FranzImsch/DreamSteck/README.md

### 3x3 Macro Pad

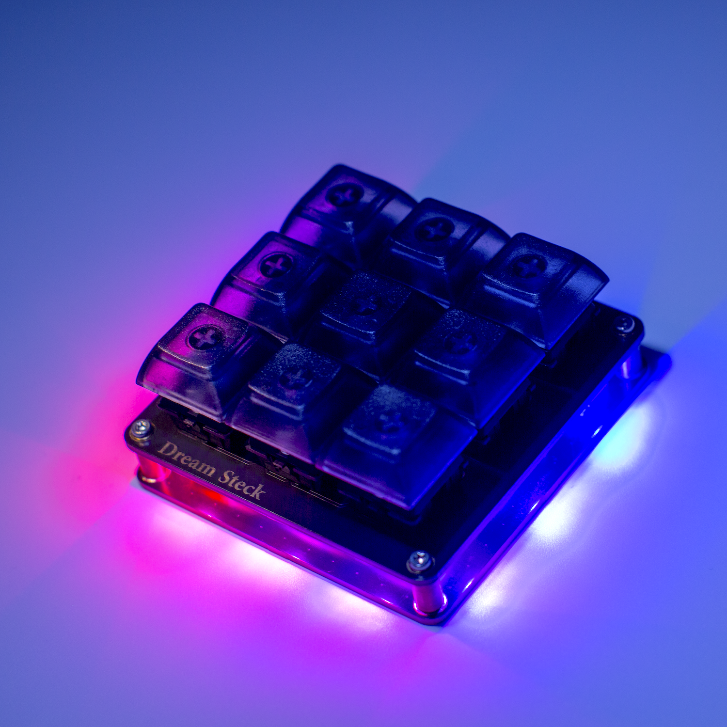
[picture p1: photo-1.png]
Overview photo


Based on nRF52840
