FranzImsch/DreamSteck/photo-2.png

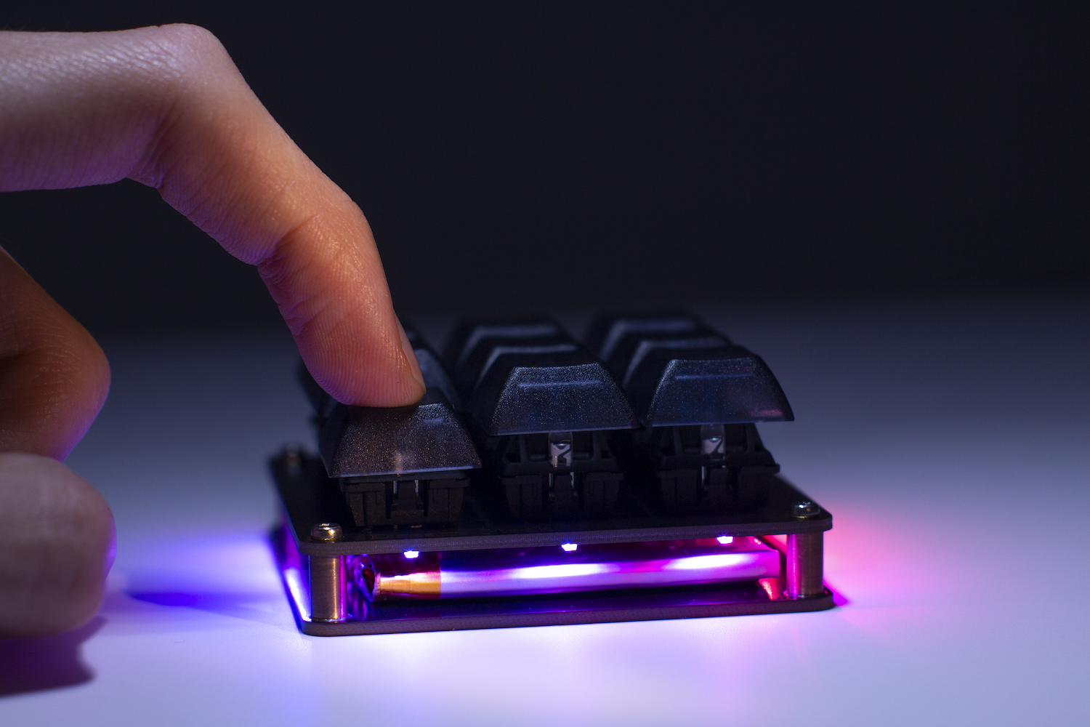
photo-2.png
