FranzImsch/DreamSteck/Schematic.pdf

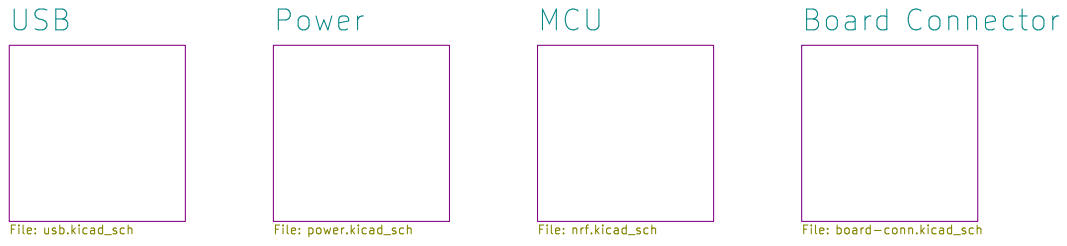
[picture p3: page 1]

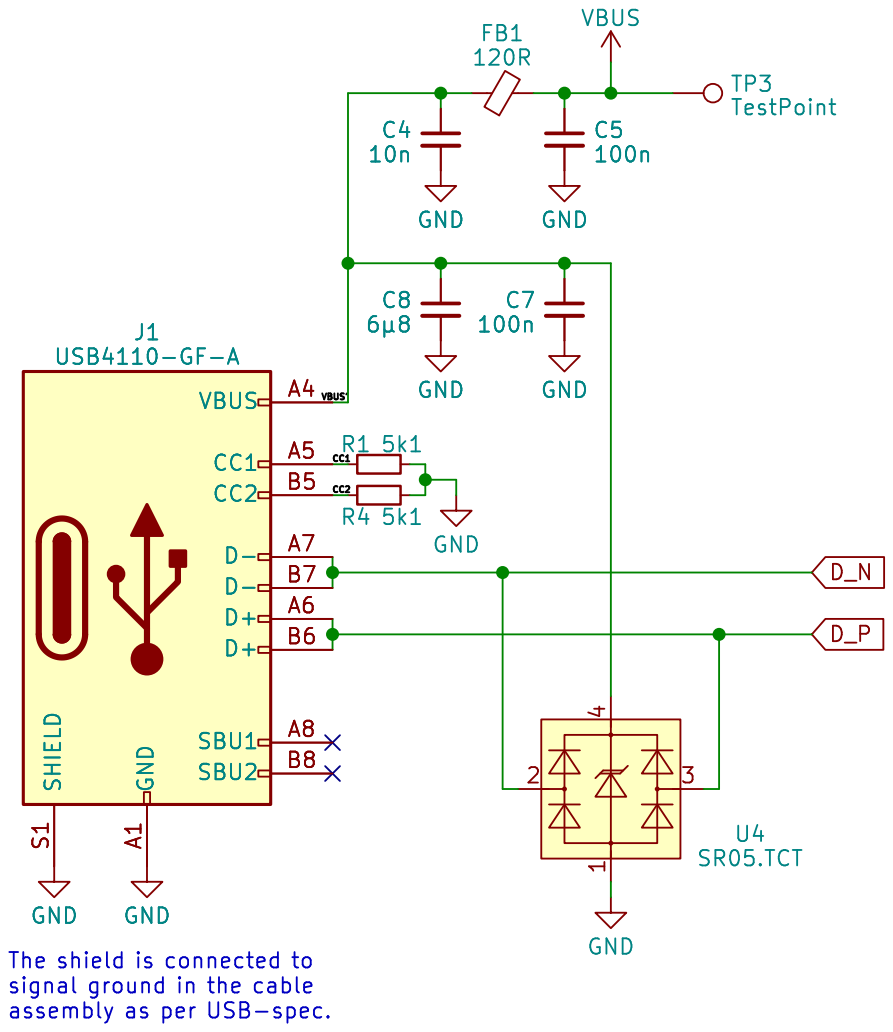
[picture p4: page 2]

signal ground in the cable

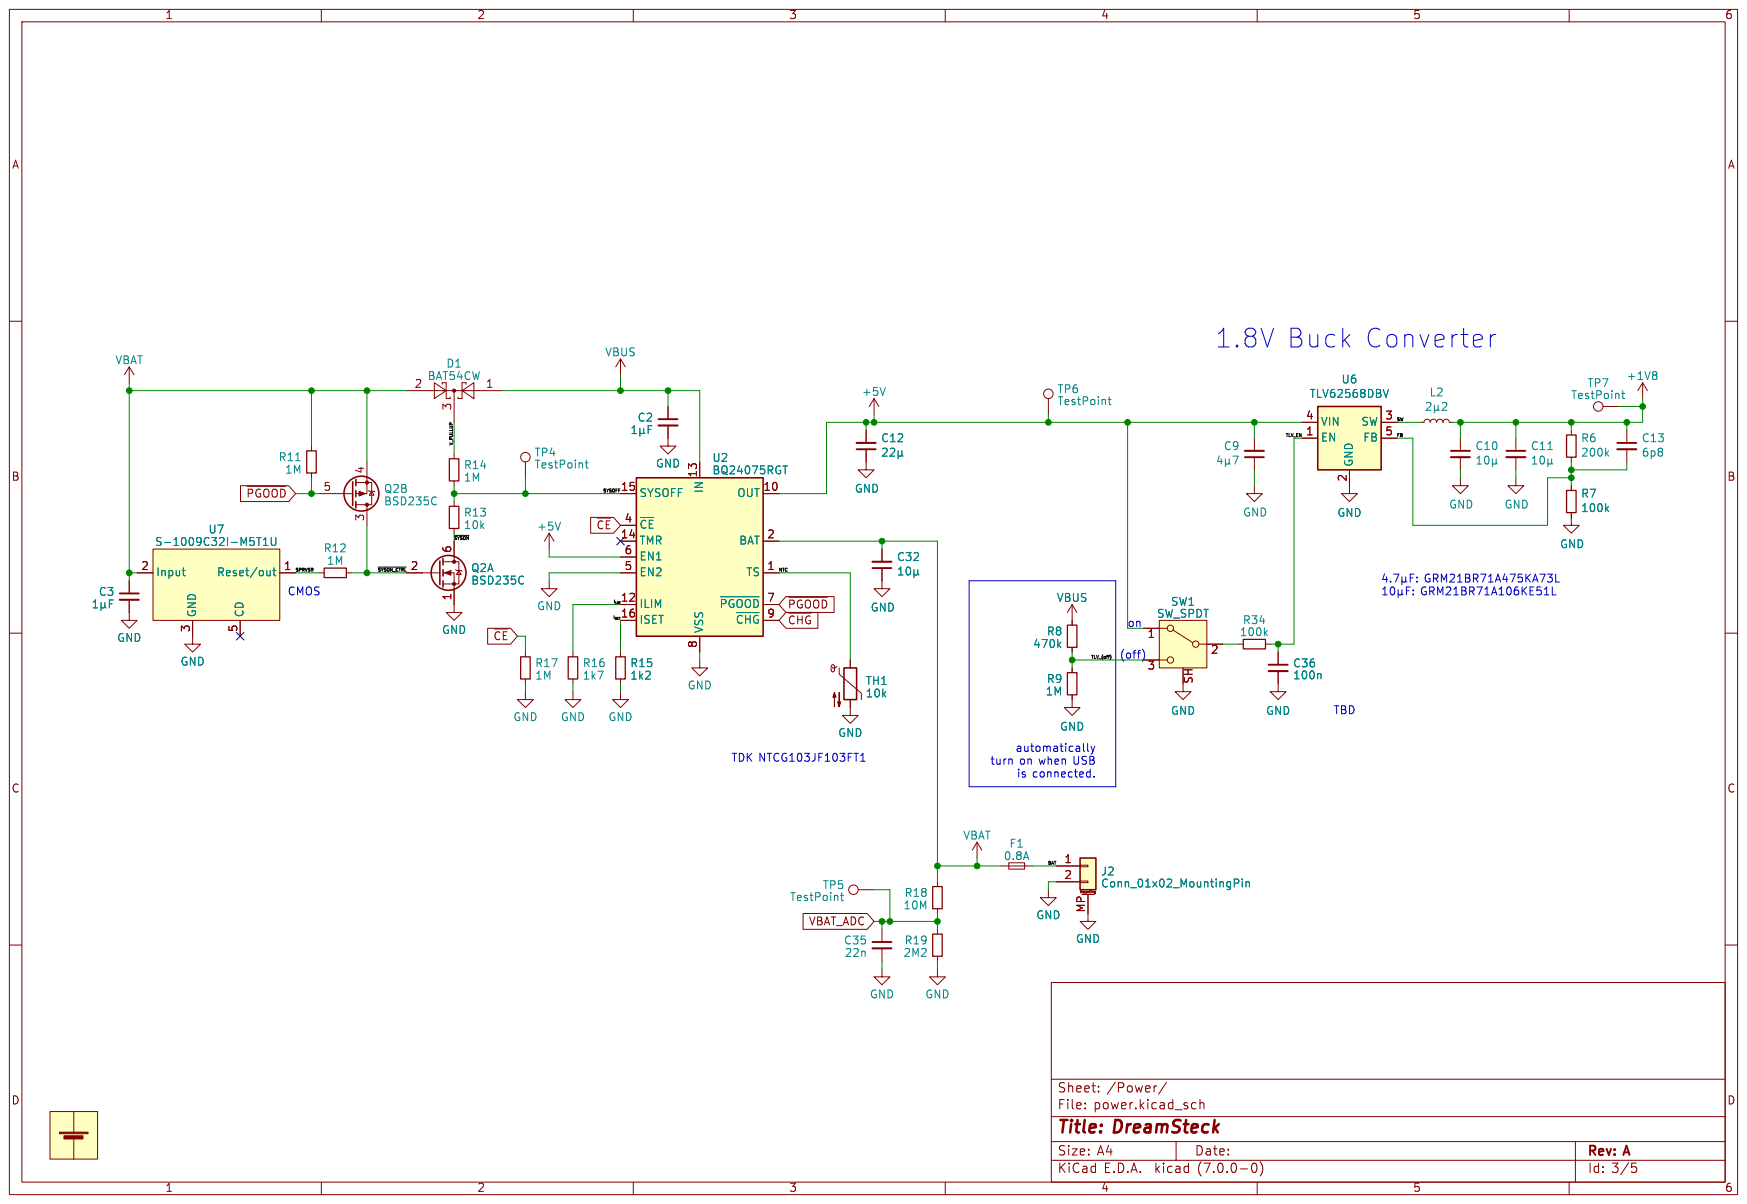
[picture p5: page 3]

automatically
turn on when USB
is connected.

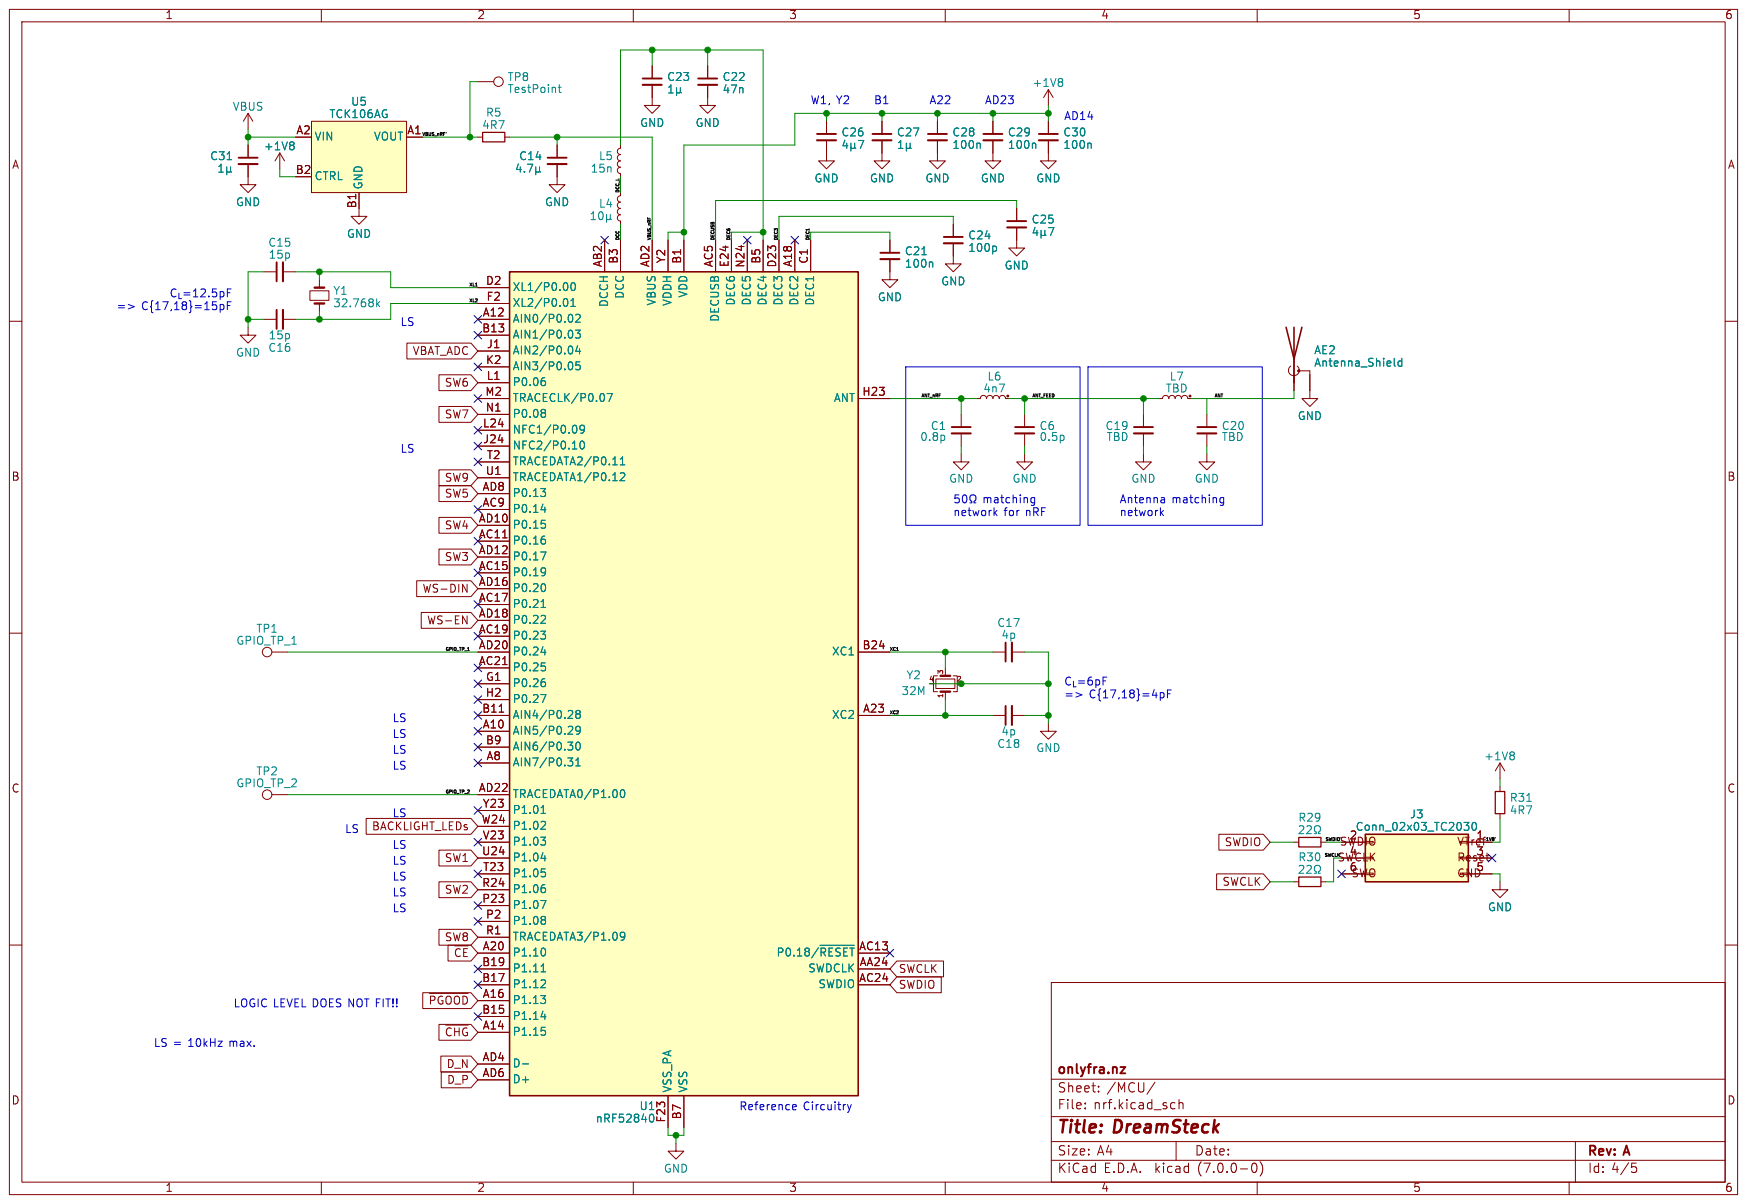
[picture p6: page 4]

LOGIC LEVEL DOES NOT FIT!!

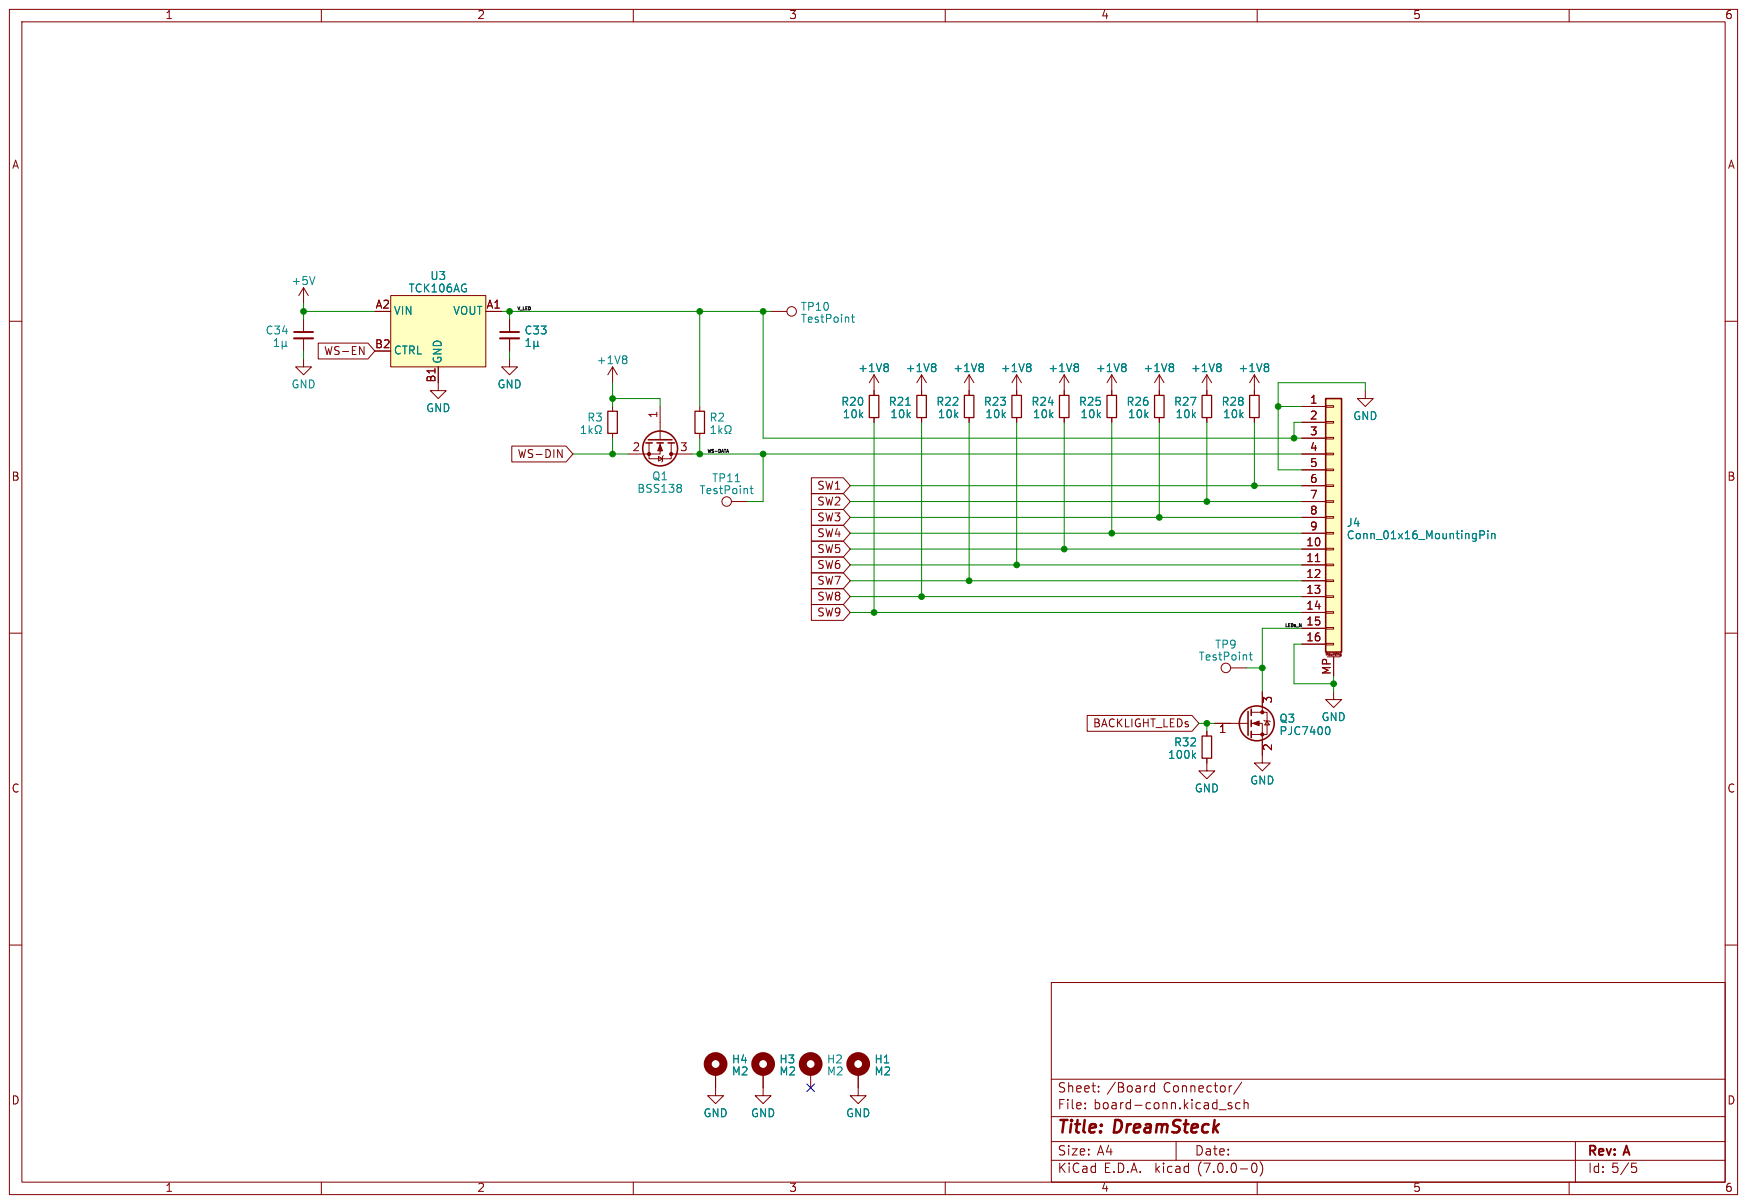
[picture p7: page 5]

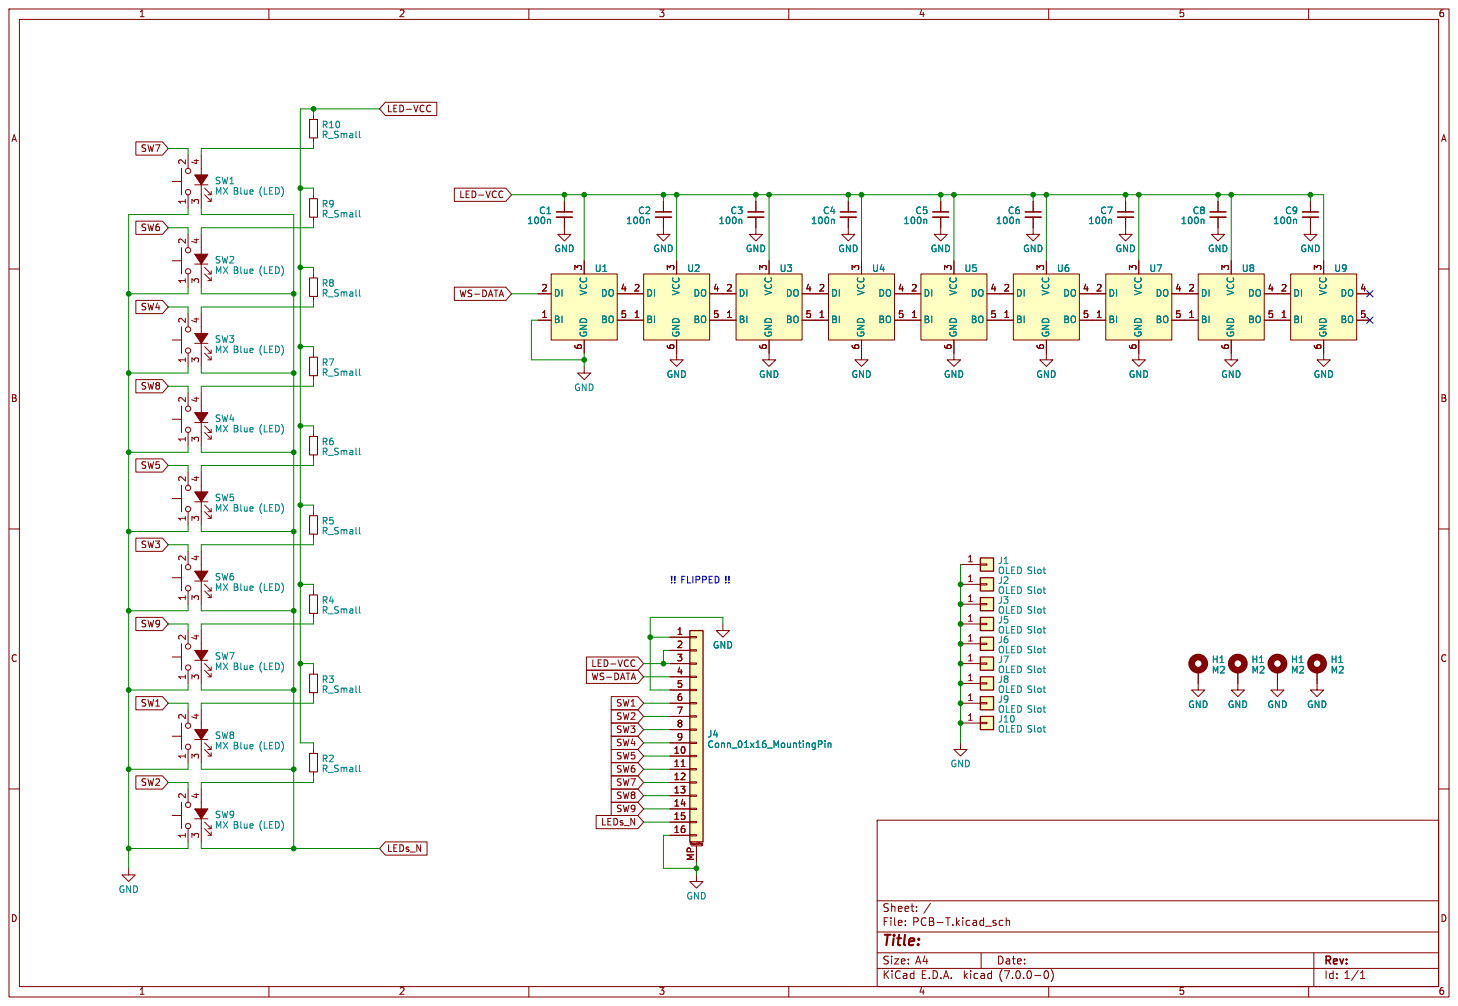
[picture p8: page 6]

3 4 SW5 MX Blue (LED) 1 J8OLED Slot 1 J1OLED Slot 1 J3OLED Slot 1 J2OLED Slot 1 J5OLED Slot 1 J6OLED Slot GND

3 4 SW9 MX Blue (LED) GND

3 4 SW6 MX Blue (LED) R4 R_Small GND
