FranzImsch/DreamSteck/KiCad/PCB-T/PCB-T.kicad_pcb

## KiCad design KiCad/PCB-T/PCB-T.kicad_pcb (2023-03-04)

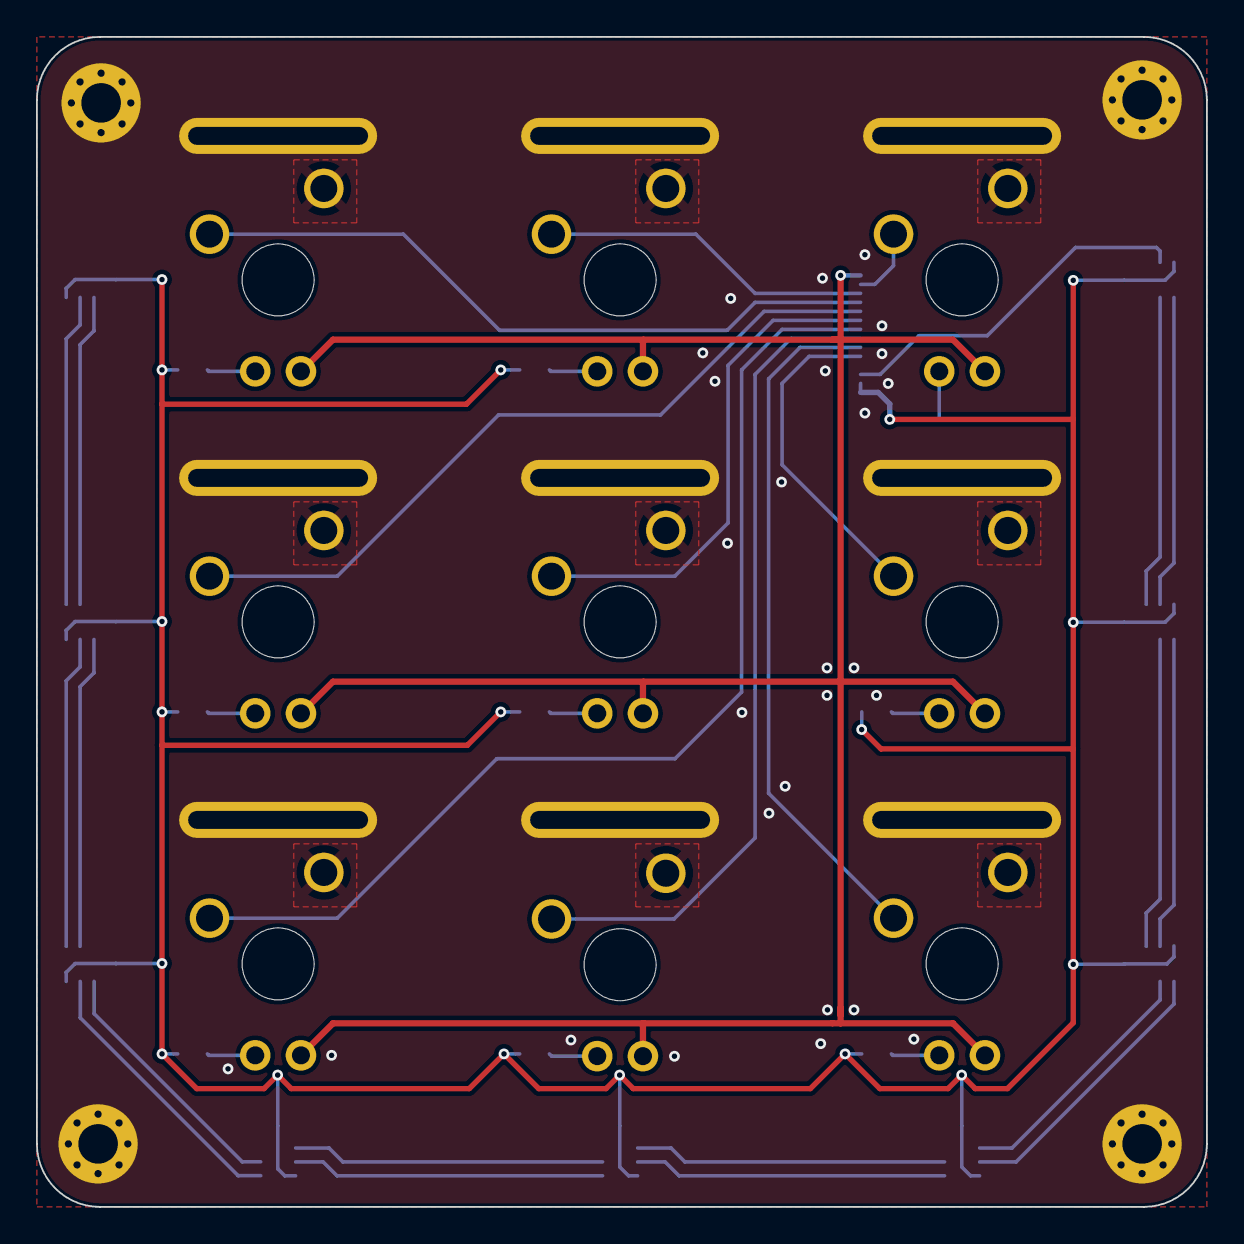
[picture p9: board PCB-T.kicad_pcb from above]

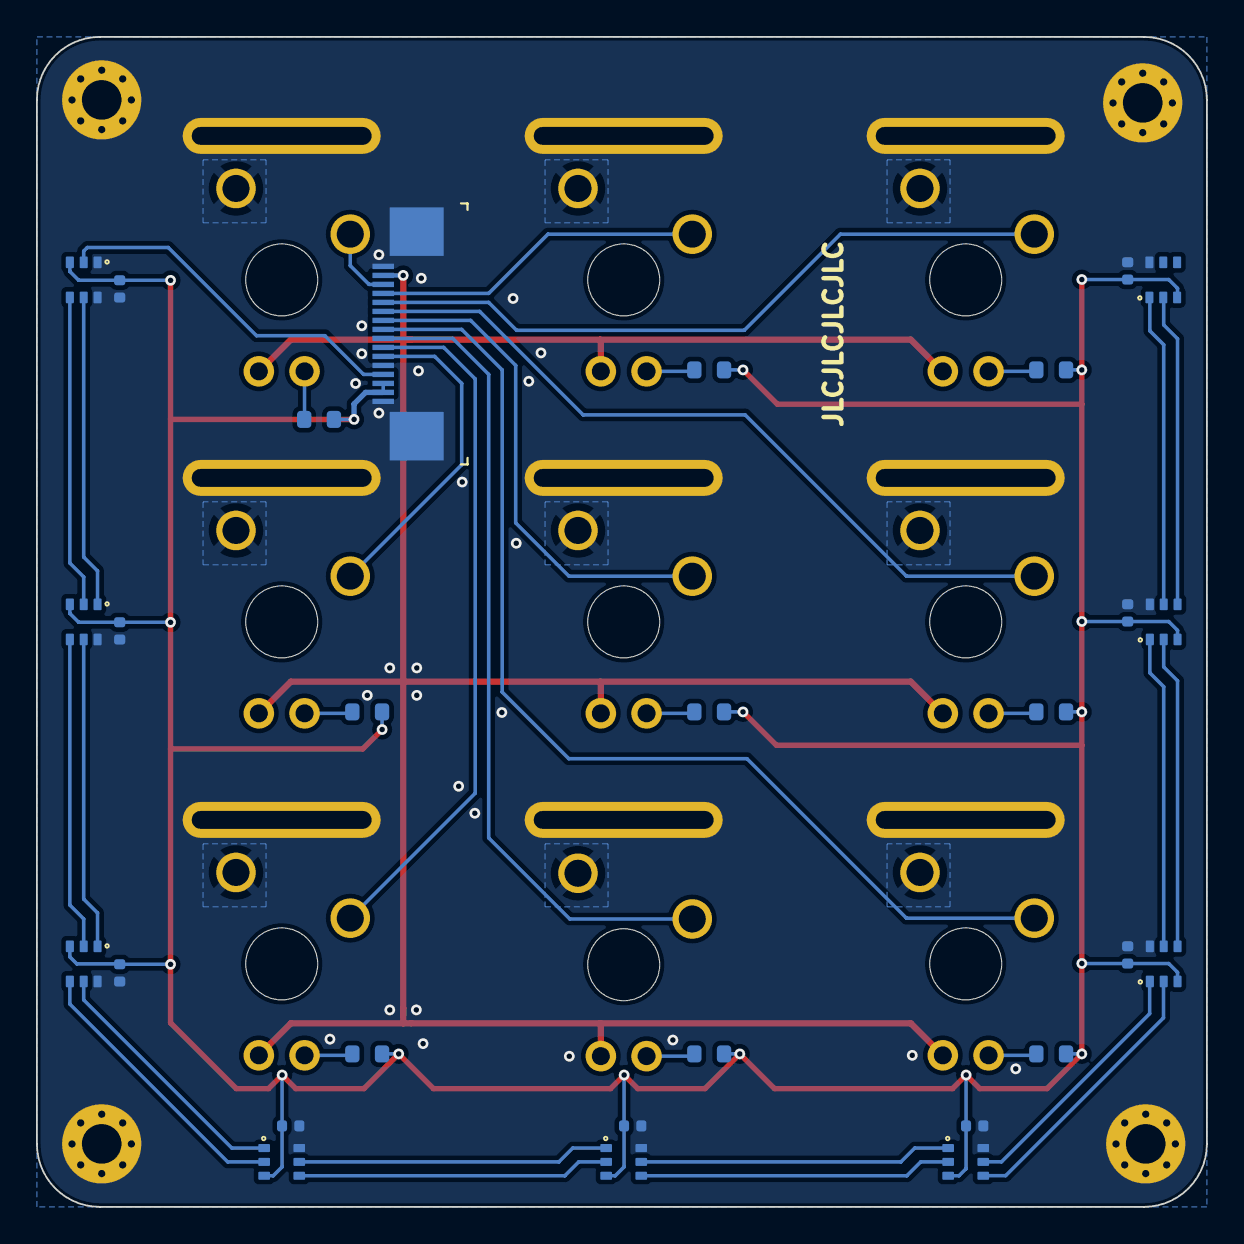
[picture p10: board PCB-T.kicad_pcb from below]

Board: 2 copper layers, 65.0 x 65.0 mm, 50 parts (32 on the bottom side), 21 nets.

Parts:
C37, C38, C39, C40, C41, C42, C43, C44, C45: 100n; C_0402_1005Metric_NoSilk
H5, H6, H7, H8: M2; MountingHole_2.2mm_M2_Pad_Via_NoSilk
J5: Conn_01x16_MountingPin; 68711614022
J6, J7, J8, J9, J10, J11, J12, J13, J14: OLED Slot; Plated_Slot_10x1mm
R33, R35, R36, R37, R38, R39, R40, R41, R42: R_Small; R_0603_1608Metric_NoSilk
SW2, SW3, SW4, SW5, SW6, SW7, SW8, SW9, SW10: MX Blue (LED); SW_Cherry_MX_1.00u_Plate_NoSilk
U9, U10, U11, U12, U13, U14, U15, U16, U17: WS2816

Connections:
GND: C37.2, C38.2, C39.2, C40.2, C41.2, C42.2, C43.2, C44.2, C45.2, H5.1, H6.1, H7.1, H8.1, J5.1, J5.5, J5.16, J5.MP (MountPin), J6.1, J7.1, J8.1, J9.1, J10.1, J11.1, J12.1, J13.1, J14.1, SW2.1, SW3.1, SW4.1, SW5.1, SW6.1, SW7.1, SW8.1, SW9.1, SW10.1, U9.1 (BI), U9.6 (GND), U10.6 (GND), U11.6 (GND), U12.6 (GND), U13.6 (GND), U14.6 (GND), U15.6 (GND), U16.6 (GND), U17.6 (GND)
LED-VCC: C37.1, C38.1, C39.1, C40.1, C41.1, C42.1, C43.1, C44.1, C45.1, J5.2, J5.3, R33.1, R35.1, R36.1, R37.1, R38.1, R39.1, R40.1, R41.1, R42.1, U9.3 (VCC), U10.3 (VCC), U11.3 (VCC), U12.3 (VCC), U13.3 (VCC), U14.3 (VCC), U15.3 (VCC), U16.3 (VCC), U17.3 (VCC)
LEDs_N: J5.15, SW2.3 (K), SW3.3 (K), SW4.3 (K), SW5.3 (K), SW6.3 (K), SW7.3 (K), SW8.3 (K), SW9.3 (K), SW10.3 (K)
unnamed: R33.2, SW2.4 (A)
unnamed: R35.2, SW3.4 (A)
unnamed: R36.2, SW4.4 (A)
unnamed: R37.2, SW5.4 (A)
unnamed: R38.2, SW6.4 (A)
unnamed: R39.2, SW7.4 (A)
unnamed: R40.2, SW8.4 (A)
unnamed: R41.2, SW9.4 (A)
SW1: J5.6, SW9.2
SW2: J5.7, SW10.2
SW3: J5.8, SW7.2
SW4: J5.9, SW4.2
SW5: J5.10, SW6.2
SW6: J5.11, SW3.2
SW7: J5.12, SW2.2
SW8: J5.13, SW5.2
SW9: J5.14, SW8.2
WS-DATA: J5.4, U9.2 (DI)
