FranzImsch/DreamSteck/KiCad/PCB-B/PCB-B.kicad_pcb

## KiCad design KiCad/PCB-B/PCB-B.kicad_pcb (2023-03-04)

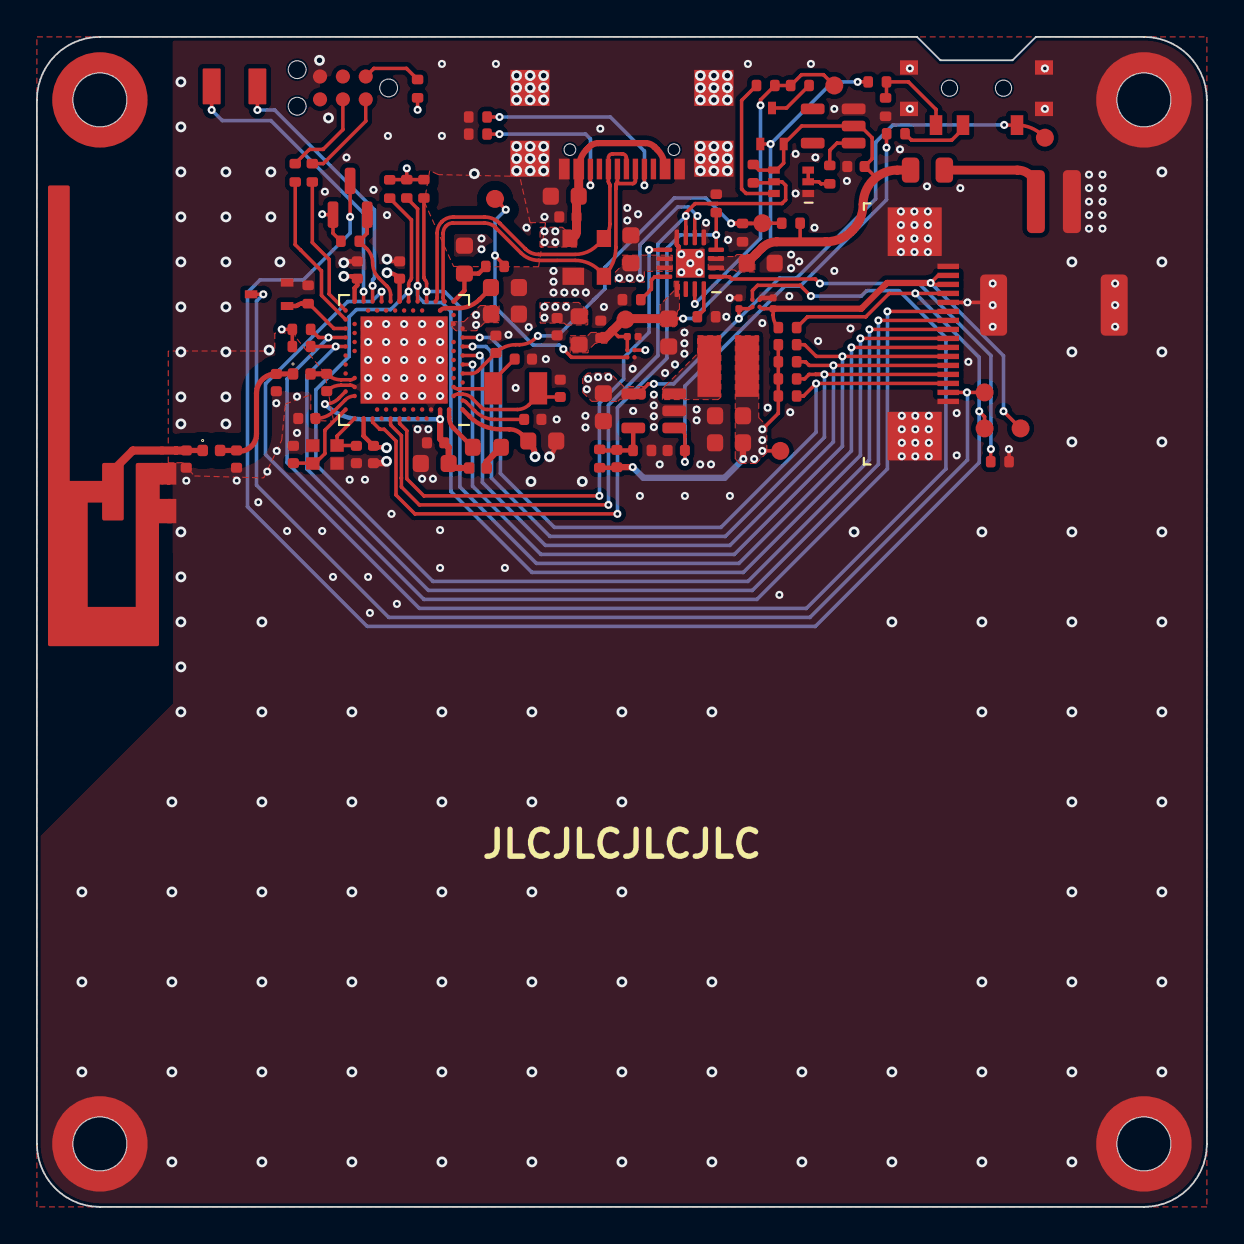
[picture p11: board PCB-B.kicad_pcb from above]

Board: 4 copper layers, 65.0 x 65.0 mm, 111 parts (0 on the bottom side), 65 nets.

Parts:
AE2: Antenna_Shield; Texas_SWRR034C_2.4GHz_Right
C1: 0.8p; C_0402_1005Metric_NoSilk
C2: 1µF; C_0603_1608Metric_NoSilk
C3: 1µF; C_0402_1005Metric_NoSilk
C4: 10n; C_0402_1005Metric_NoSilk
C5, C7, C21, C28, C29, C30, C36: 100n; C_0402_1005Metric_NoSilk
C6: 0.5p; C_0402_1005Metric_NoSilk
C8: 6µ8; C_0603_1608Metric_NoSilk
C9, C25, C26: 4µ7; C_0603_1608Metric_NoSilk
C10, C11, C32: 10µ; C_0603_1608Metric_NoSilk
C12: 22µ; C_0603_1608Metric_NoSilk
C13: 6p8; C_0402_1005Metric_NoSilk
C14: 4.7µ; C_0603_1608Metric_NoSilk
C15, C16: 15p; C_0402_1005Metric_NoSilk
C17, C18: 4p; C_0402_1005Metric_NoSilk
C19, C20: TBD; C_0402_1005Metric_NoSilk
C22: 47n; C_0402_1005Metric_NoSilk
C23, C27: 1µ; C_0603_1608Metric_NoSilk
C24: 100p; C_0402_1005Metric_NoSilk
C31, C33, C34: 1µ; C_0201_0603Metric_NoSilk
C35: 22n; C_0402_1005Metric_NoSilk
D1: BAT54CW; SOT-323_SC-70_NoSilk
F1: 0.8A; Fuse_0805_2012Metric_NoSilk
FB1: 120R; L_0603_1608Metric_NoSilk
H1, H2, H3, H4: M2; Mounting_Wuerth_WA-SMSI-M2_H8mm_9774080243_NoSilk
J1: USB4110-GF-A; GCT_USB4110-GF-A
J2: Conn_01x02_MountingPin; JST_PH_S2B-PH-SM4-TB_1x02-1MP_P2.00mm_Horizontal
J3: Conn_02x03_TC2030; Tag-Connect_TC2030-IDC-NL_2x03_P1.27mm_Vertical_NoSilk
J4: Conn_01x16_MountingPin; 68711614022
L2: 2µ2; L_Wuerth_MAPI-3012_NoSilk
L4: 10µ; L_0603_1608Metric_NoSilk
L5: 15n; L_0402_1005Metric_NoSilk
L6: 4n7; L_0402_1005Metric_Polarised_NoSilk_Dot
L7: TBD; L_0402_1005Metric_Polarised_NoSilk_Dot
Q1: BSS138; SOT-23_NoSilk
Q2: BSD235C; SOT-363_SC-70-6_NoSilk
Q3: PJC7400; SOT-323_SC-70_NoSilk
R1, R4: 5k1; R_0402_1005Metric_NoSilk
R2, R3: 1kΩ; R_0402_1005Metric_NoSilk
R5, R31: 4R7; R_0402_1005Metric_NoSilk
R6: 200k; R_0402_1005Metric_NoSilk
R7, R32, R34: 100k; R_0402_1005Metric_NoSilk
R8: 470k; R_0402_1005Metric_NoSilk
R9, R11, R12, R14, R17: 1M; R_0402_1005Metric_NoSilk
R13, R20, R21, R22, R23, R24, R25, R26, R27, R28: 10k; R_0402_1005Metric_NoSilk
R15: 1k2; R_0402_1005Metric_NoSilk
R16: 1k7; R_0402_1005Metric_NoSilk
R18: 10M; R_0402_1005Metric_NoSilk
R19: 2M2; R_0402_1005Metric_NoSilk
R29, R30: 22Ω; R_0402_1005Metric_NoSilk
SW1: SW_SPDT; 450404015514
TH1: 10k; R_0402_1005Metric_NoSilk
TP1: GPIO_TP_1; TestPoint_Pad_1.0x2.0mm_NoSilk
TP2: GPIO_TP_2; TestPoint_Pad_1.0x2.0mm_NoSilk
TP3, TP4, TP5, TP6, TP7, TP8, TP9, TP10, TP11: TestPoint; TestPoint_Pad_D1.0mm_NoSIlk
U1: nRF52840; Nordic_AQFN-73-1EP_7x7mm_P0.5mm_NoSilk
U2: BQ24075RGT; VQFN-16-1EP_3x3mm_P0.5mm_EP1.6x1.6mm_NoSilk
U3, U5: TCK106AG; WCSPD-4_NoSilk
U4: SR05.TCT; SOT143-4L-slim
U6: TLV62568DBV; SOT-23-5_NoSilk
U7: S-1009C32I-M5T1U; SOT-23-5_NoSilk
U8: LiIon-5x34x50
Y1: 32.768k; Crystal_SMD_3215-2Pin_NoSilk
Y2: 32M; OSC_XRCGB24M000F3M01R0

Connections:
+1V8: C10.1, C11.1, C13.1, C26.1, C27.1, C28.1, C29.1, C30.1, L2.2, Q1.1 (G), R3.1, R6.1, R20.1, R21.1, R22.1, R23.1, R24.1, R25.1, R26.1, R27.1, R28.1, R31.1, TP7.1, U1.A22 (VDD), U1.AD14 (VDD), U1.AD23 (VDD), U1.B1 (VDD), U1.W1 (VDD), U1.Y2 (VDDH), U5.B2 (CTRL)
+5V: C9.2, C12.2, C34.1, SW1.1 (A), TP6.1, U2.6 (EN1), U2.10 (OUT), U2.11 (OUT), U3.A2 (VIN), U6.4 (VIN)
/Board Connector/LEDs_N: J4.15, Q3.3 (D), TP9.1
/Board Connector/V_LED: C33.1, J4.2, J4.3, R2.1, TP10.1, U3.A1 (VOUT)
/Board Connector/WS-DATA: J4.4, Q1.3 (D), R2.2, TP11.1
/MCU/1V8': J3.1, R31.2
/MCU/ANT: AE2.1 (A), C20.1, L7.2
/MCU/ANT_FEED: C6.1, C19.1, L6.2, L7.1
/MCU/ANT_nRF: C1.1, L6.1, U1.H23 (ANT)
/MCU/DCC: L4.2, U1.B3 (DCC)
/MCU/DCC_L: L4.1, L5.2
/MCU/DEC1: C21.1, U1.C1 (DEC1)
/MCU/DEC3: C24.1, U1.D23 (DEC3)
/MCU/DEC6: C22.1, C23.1, L5.1, U1.B5 (DEC4), U1.E24 (DEC6)
/MCU/DECUSB: C25.1, U1.AC5 (DECUSB)
/MCU/GPIO_TP_1: TP1.1, U1.AD20 (P0.24)
/MCU/GPIO_TP_2: TP2.1, U1.AD22 (TRACEDATA0/P1.00)
/MCU/SWCLK': J3.4, R30.2
/MCU/SWDIO': J3.2, R29.2
/MCU/VBUS_nRF: C14.1, R5.2, U1.AD2 (VBUS)
/MCU/VBUS_nRF': R5.1, TP8.1, U5.A1 (VOUT)
/MCU/XC1: C17.1, U1.B24 (XC1), Y2.3
/MCU/XC2: C18.1, U1.A23 (XC2), Y2.1
/MCU/XL1: C15.2, U1.D2 (XL1/P0.00), Y1.2
/MCU/XL2: C16.2, U1.F2 (XL2/P0.01), Y1.1
/Power/BAT: F1.2, J2.1
/Power/FB: C13.2, R6.2, R7.1, U6.5 (FB)
/Power/I_{LIM}: R16.1, U2.12 (ILIM)
/Power/I_{SET}: R15.1, U2.16 (ISET)
/Power/NTC: TH1.1, U2.1 (TS)
/Power/SPRVSR: R12.1, U7.1 (Reset/out)
/Power/SW: L2.1, U6.3 (SW)
/Power/SYSOFF: R13.1, R14.2, TP4.1, U2.15 (SYSOFF)
/Power/TLV_(off): R8.2, R9.1, SW1.3 (C)
/Power/TLV_EN: C36.1, R34.2, U6.1 (EN)
/Power/V_PULLUP: D1.3, R14.1
/Power/~SYSON_CTRL: Q2.2 (GN), Q2.3 (DP), R12.2
/Power/~SYSON: Q2.6 (DN), R13.2
/USB/CC1: J1.A5 (CC1), R1.1
/USB/CC2: J1.B5 (CC2), R4.1
/USB/VBUS': C4.1, C7.1, C8.1, FB1.1, J1.A4 (VBUS), J1.A9 (VBUS), J1.B4 (VBUS), J1.B9 (VBUS), U4.4 (VBUS)
BACKLIGHT_LEDs: Q3.1 (G), R32.1, U1.W24 (P1.02)
D_N: J1.A7 (D-), J1.B7 (D-), U1.AD4 (D-), U4.2 (CH1)
D_P: J1.A6 (D+), J1.B6 (D+), U1.AD6 (D+), U4.3 (CH2)
GND: AE2.2 (Shield), C1.2, C2.2, C3.2, C4.2, C5.2, C6.2, C7.2, C8.2, C9.1, C10.2, C11.2, C12.1, C14.2, C15.1, C16.1, C17.2, C18.2, C19.2, C20.2, C21.2, C22.2, C23.2, C24.2, C25.2, C26.2, C27.2, C28.2, C29.2, C30.2, C31.2, C32.1, C33.2, C34.2, C35.2, C36.2, H1.1, H3.1, H4.1, J1.A1 (GND), J1.A12 (GND), J1.B1 (GND), J1.B12 (GND), J1.S1 (SHIELD), J2.2, J2.MP (MountPin), J3.5, J4.1, J4.5, J4.16, J4.MP (MountPin), Q2.1 (SN), Q3.2 (S), R1.2, R4.2, R7.2, R9.2, R15.2, R16.2, R17.2, R19.2, R32.2, SW1.SH (MP), TH1.2, U1.B7 (VSS), U1.EP (VSS), U1.F23 (VSS_PA), U2.5 (EN2), U2.8 (VSS), U2.17 (VSS), U3.B1 (GND), U4.1 (GND), U5.B1 (GND), U6.2 (GND), U7.3 (GND), Y2.2, Y2.4
unnamed: R34.1, SW1.2 (B)
SW1: J4.6, R28.2, U1.U24 (P1.04)
SW2: J4.7, R27.2, U1.R24 (P1.06)
SW3: J4.8, R26.2, U1.AD12 (P0.17)
SW4: J4.9, R25.2, U1.AD10 (P0.15)
SW5: J4.10, R24.2, U1.AD8 (P0.13)
SW6: J4.11, R23.2, U1.L1 (P0.06)
SW7: J4.12, R22.2, U1.N1 (P0.08)
SW8: J4.13, R21.2, U1.R1 (TRACEDATA3/P1.09)
SW9: J4.14, R20.2, U1.U1 (TRACEDATA1/P0.12)
SWCLK: R30.1, U1.AA24 (SWDCLK)
SWDIO: R29.1, U1.AC24 (SWDIO)
VBAT: C3.1, C32.2, D1.2, F1.1, Q2.4 (SP), R11.1, R18.1, U2.2 (BAT), U2.3 (BAT), U7.2 (Input)
VBAT_ADC: C35.1, R18.2, R19.1, TP5.1, U1.J1 (AIN2/P0.04)
VBUS: C2.1, C5.1, C31.1, D1.1, FB1.2, R8.1, TP3.1, U2.13 (IN), U5.A2 (VIN)
WS-DIN: Q1.2 (S), R3.2, U1.AD16 (P0.20)
WS-EN: U1.AD18 (P0.22), U3.B2 (CTRL)
~CE: R17.1, U1.A20 (P1.10), U2.4 (~CE)
~CHG: U1.A14 (P1.15), U2.9 (~CHG)
~PGOOD: Q2.5 (GP), R11.2, U1.A16 (P1.13), U2.7 (~PGOOD)
